IYuSheng/H_FOC-V3.0/boards/stm32g431/hardware/schematic.pdf

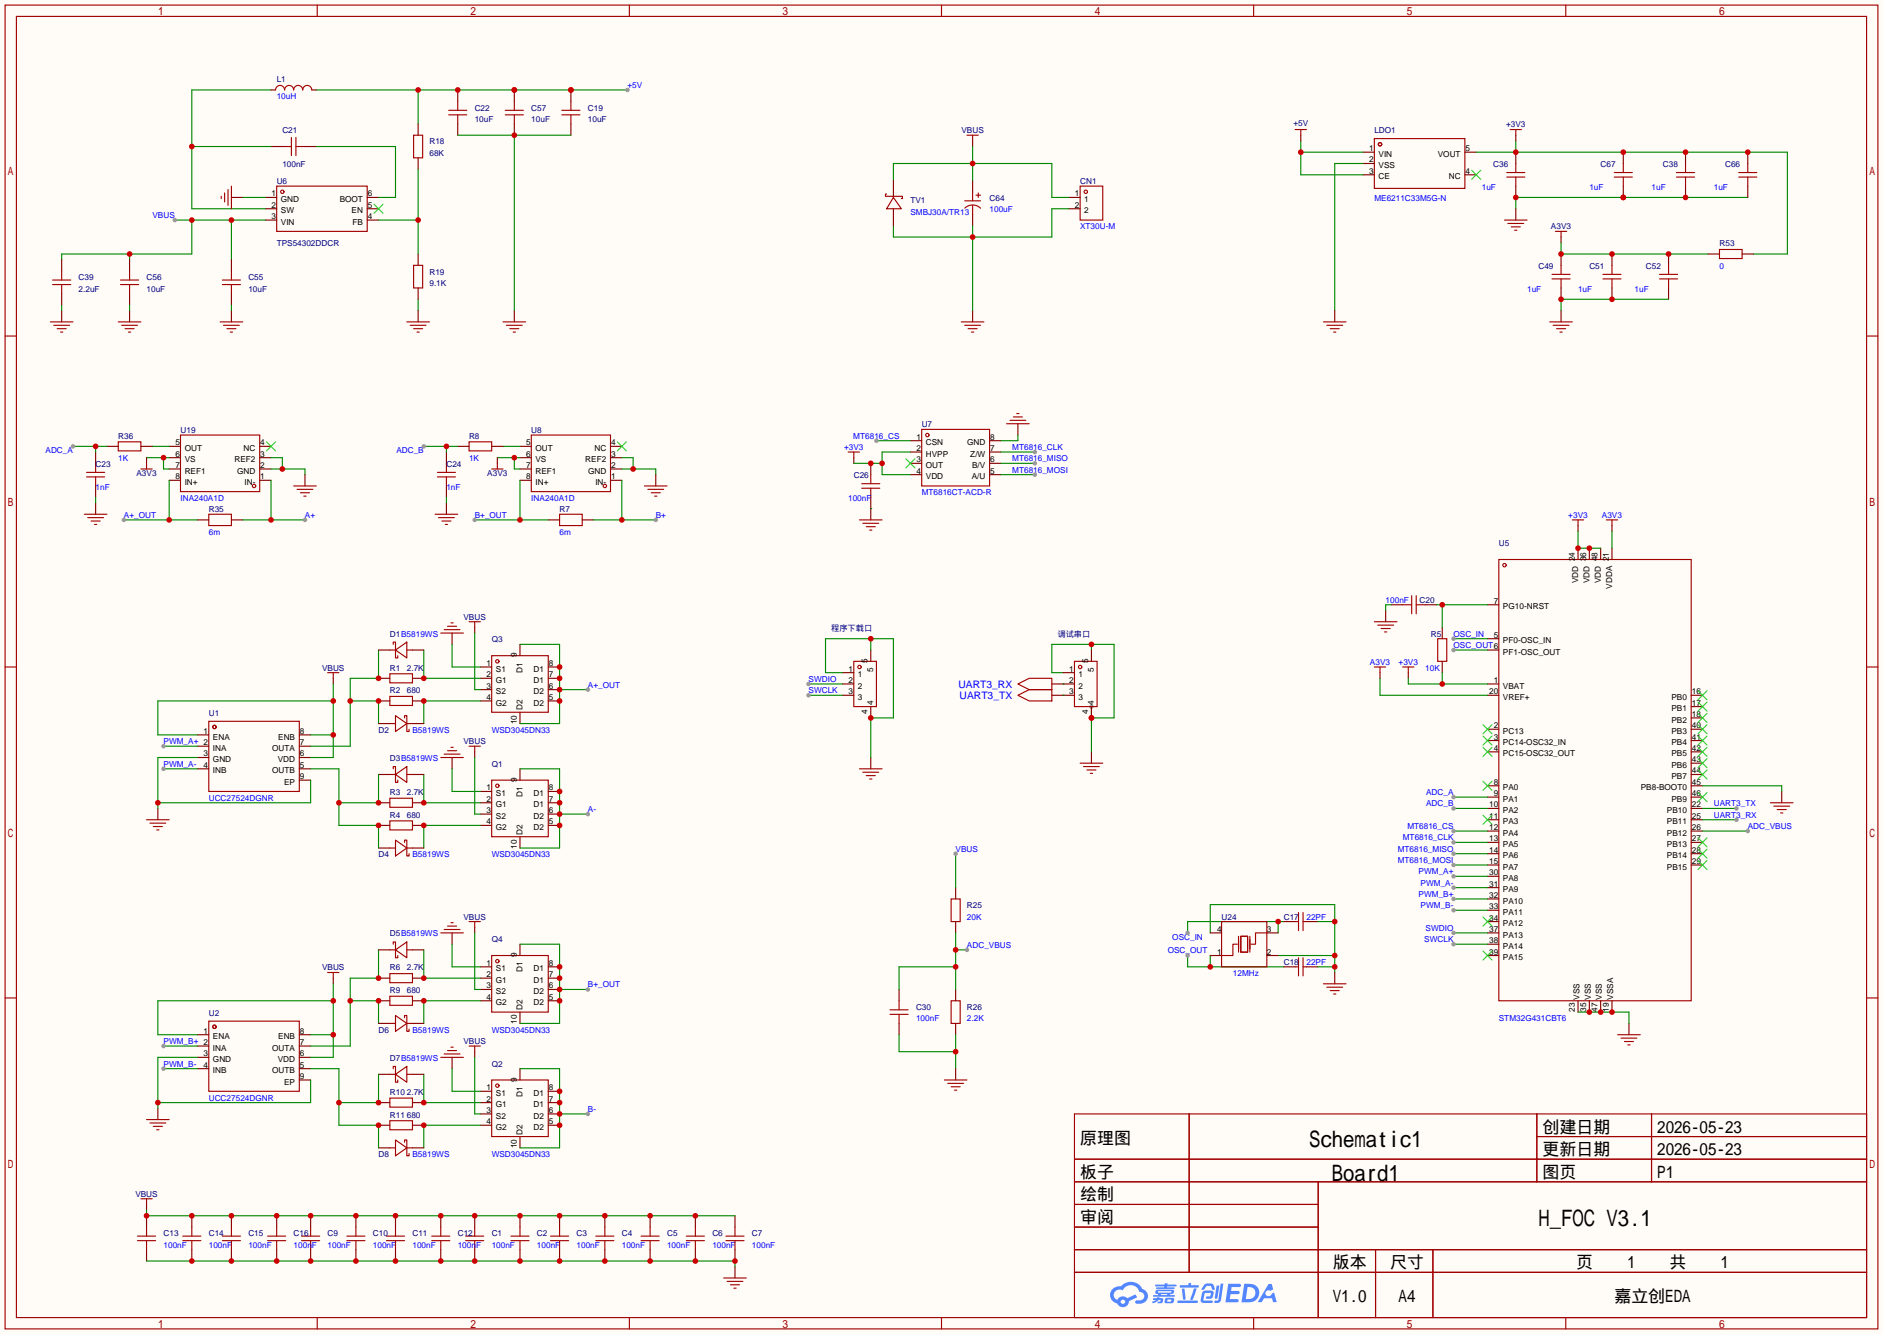
[picture p1: page 1]

原理图 | Schematic1 | 创建日期 | 2026-05-23

更新日期 | 2026-05-23

板子 | Board1 | 图页 | P1
绘制 | | H_FOC V3.1
审阅

V1.0 | A4 | 嘉立创EDA
