IYuSheng/H_FOC-V3.0/boards/stm32g431/hardware/PCB_bottom.pdf

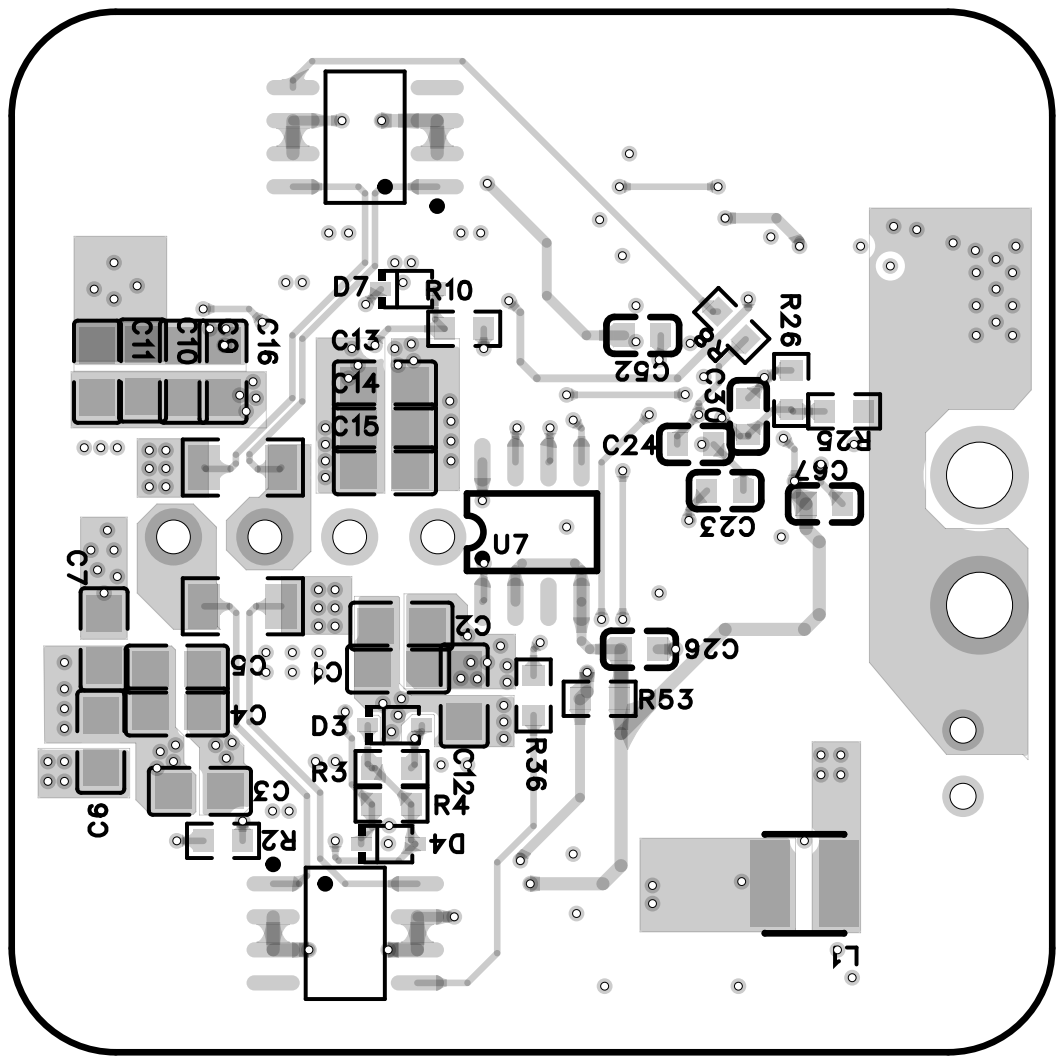
[picture p2: page 1]
