IYuSheng/H_FOC-V3.0/boards/stm32g431/hardware/PCB_top.pdf

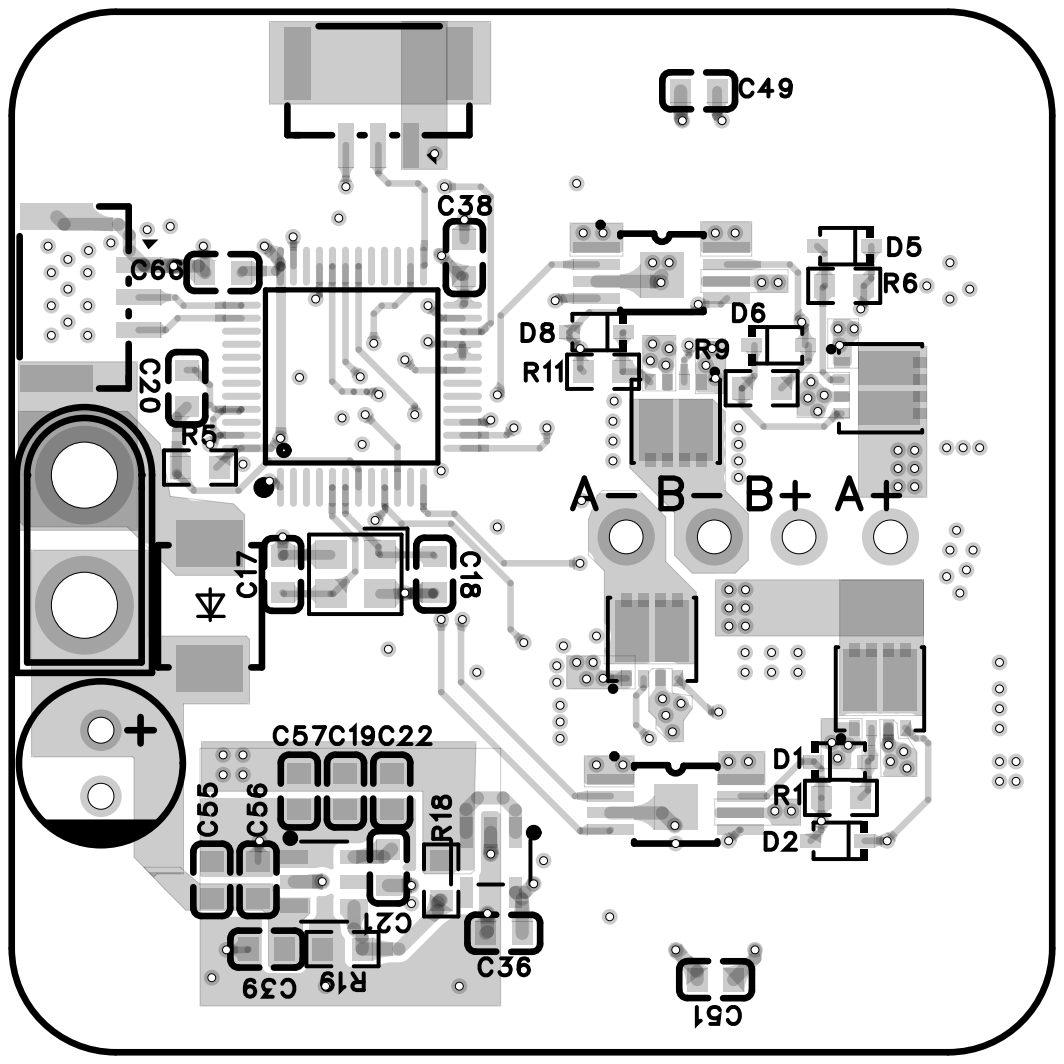
[picture p3: page 1]
