IYuSheng/H_FOC-V3.0/Code/MID/foc_conversion.c

#include "foc_conversion.h"

pi_t iq_pid;
pi_t id_pid;
pi_t speed_pid;
pi_t position_pid;
SVPWM_t svpwm;
SPWM_t spwm;
foc_control_t foc_ctrl;
AlphaBetaTypeDef alpha_beta;

/**
 * @brief 电角度归一化（映射到0~2π范围）
 * @param angle 输入电角度（rad，范围无限制）
 * @return 归一化后电角度（rad，0~2π）
 */
float angle_normalize(float angle)
{
    while (angle < 0.0f)   angle += _2PI;
    while (angle >= _2PI)  angle -= _2PI;
    return angle;
}

/**
 * @brief 电角度归一化（映射到-π~π范围）
 * @param angle 输入电角度（rad，范围无限制）
 * @return 归一化后电角度（rad，-π~π）
 */
float angle_normalize_pi(float angle)
{
    while (angle < -_PI)   angle += _2PI;
    while (angle >= _PI)  angle -= _2PI;
    return angle;
}

static inline float clampf(float x, float min_v, float max_v)
{
    if (x > max_v) return max_v;
    if (x < min_v) return min_v;
    return x;
}

/**
 * @brief SVPWM通用扇区判断函数
 * @param u_alpha α轴目标电压（V）
 * @param u_beta  β轴目标电压（V）
 * @return 扇区编号（1~6，对应一电角周期的六个扇区）
 */
uint8_t svpwm_sector_calc(AlphaBetaTypeDef *alpha_beta)
{
    uint8_t sector, pos1, pos2, pos3 = 0;

    float X = alpha_beta->beta;
    float Y = (_SQRT3  * alpha_beta->alpha - alpha_beta->beta);
    float Z = (-_SQRT3 * alpha_beta->alpha - alpha_beta->beta);

    pos1 = (X > 1e-6f) ? 1 : 0;
    pos2 = (Y > 1e-6f) ? 1 : 0;
    pos3 = (Z > 1e-6f) ? 1 : 0;

    sector = pos1 * 1 + pos2 * 2 + pos3 * 4;

    switch (sector)
    {
        case 3:  return 1;
        case 1:  return 2;
        case 5:  return 3;
        case 4:  return 4;
        case 6:  return 5;
        case 2:  return 6;
        default: return -1;
    }
}

/**
 * @brief SVPWM基本矢量作用时间计算
 * @param sector 当前扇区（1~6）
 * @param u_alpha α轴目标电压（V）
 * @param u_beta  β轴目标电压（V）
 * @param vdc 母线电压（V）
 * @param T1 第一个基本矢量作用时间（s）
 * @param T2 第二个基本矢量作用时间（s）
 * @param T0 零矢量总作用时间（s）
 */
void svpwm_calc_times(AlphaBetaTypeDef *alpha_beta, SVPWM_t *svpwm, float vdc)
{
    // 1) 计算幅值平方
    float alpha = alpha_beta->alpha;
    float beta  = alpha_beta->beta;
    float u_mag_sq = alpha * alpha + beta * beta;
    const float u_max = _1_SQRT3 * vdc;
    const float u_max_sq = u_max * u_max;

    // 2) 过调制处理
    if (u_mag_sq > u_max_sq && u_mag_sq > 1e-12f)
    {
        float u_mag = sqrtf(u_mag_sq);
        float scale = u_max / u_mag;
        alpha *= scale;
        beta  *= scale;
        alpha_beta->alpha = alpha;
        alpha_beta->beta  = beta;
    }

    // 3) 中间变量计算
    float factor = FACTOR / vdc;
    float half_factor = factor * 0.5f;
    float X = beta * factor;
    float Y = ( _SQRT3 * alpha + beta) * half_factor;
    float Z = (beta -_SQRT3 * alpha) * half_factor;

    // 4. 按扇区计算T1和T2（基于X/Y/Z）
    switch (svpwm->sector)
    {
        case 1:  // 扇区1：V4(100) + V6(110) → T1=-Z, T2=X 3
            svpwm->T1 = -Z;
            svpwm->T2 = X;
            break;
        case 2:  // 扇区2：V6(110) + V2(010) → T1=Z, T2=Y 1
            svpwm->T1 = Z;
            svpwm->T2 = Y;
            break;
        case 3:  // 扇区3：V2(010) + V3(011) → T1=X, T2=-Y 5
            svpwm->T1 = X;
            svpwm->T2 = -Y;
            break;
        case 4:  // 扇区4：V3(011) + V1(001) → T1=-X, T2=Z 4
            svpwm->T1 = -X;
            svpwm->T2 = Z;
            break;
        case 5:  // 扇区5：V1(001) + V5(101) → T1=-Y, T2=-Z 6
            svpwm->T1 = -Y;
            svpwm->T2 = -Z;
            break;
        case 6:  // 扇区6：V5(101) + V4(100) → T1=Y, T2=-X 2
            svpwm->T1 = Y;
            svpwm->T2 = -X;
            break;
        default:
            svpwm->T1 = 0.0f;
            svpwm->T2 = 0.0f;
            break;
    }

    // 6. 计算零矢量时间（确保T0≥0，避免负数）
    svpwm->T0 = PWM_PERIOD_S - svpwm->T1 - svpwm->T2;
    if (svpwm->T0 < 0.0f) svpwm->T0 = 0.0f;
}

/**
 * @brief SVPWM计算三相导通时间并转换为比较值
 * @param sector 当前扇区 (1-6)
 * @param T1 基本矢量1作用时间
 * @param T2 基本矢量2作用时间
 * @param T0 零矢量作用时间
 * @param pwm_a A相比较值指针
 * @param pwm_b B相比较值指针
 * @param pwm_c C相比较值指针
 */
void svpwm_duty_calc(SVPWM_t *svpwm)
{
    float Ta, Tb, Tc;                 // 三相桥臂导通时间（s）
    float T0_half = svpwm->T0 / 2.0f;

    // 按扇区计算三相导通时间
    switch (svpwm->sector)
    {
        case 1:  // 扇区1
            Ta = T0_half + svpwm->T1 + svpwm->T2;
            Tb = T0_half + svpwm->T2;
            Tc = T0_half;
            break;
        case 2:  // 扇区2
            Ta = T0_half + svpwm->T2;
            Tb = T0_half + svpwm->T1 + svpwm->T2;
            Tc = T0_half;
            break;
        case 3:  // 扇区3
            Ta = T0_half;
            Tb = T0_half + svpwm->T1 + svpwm->T2;
            Tc = T0_half + svpwm->T2;
            break;
        case 4:  // 扇区4
            Ta = T0_half;
            Tb = T0_half + svpwm->T2;
            Tc = T0_half + svpwm->T1 + svpwm->T2;
            break;
        case 5:  // 扇区5
            Ta = T0_half + svpwm->T2;
            Tb = T0_half;
            Tc = T0_half + svpwm->T1 + svpwm->T2;
            break;
        case 6:  // 扇区6
            Ta = T0_half + svpwm->T1 + svpwm->T2;
            Tb = T0_half;
            Tc = T0_half + svpwm->T2;
            break;
        default:  // 异常扇区
            Ta = T0_half;
            Tb = T0_half;
            Tc = T0_half;
            break;
    }
    // 导通时间→比较值
    const float k = PWM_FREQ_PERIOD;
    svpwm->pwm_a = Ta * k;
    svpwm->pwm_b = Tb * k;
    svpwm->pwm_c = Tc * k;
}

/**
 * @brief 生成单极性倍频SPWM波
 * @param spwm 四相spwm比较值指针
 * @param alpha_beta 输出的αβ轴值
 * @param vbus 母线电压
 */
void spwm_duty_calc(SPWM_t *spwm, AlphaBetaTypeDef *alpha_beta, float vbus)
{
    const float pwm_period = PWM_PERIOD;
    float UA = clampf(alpha_beta->alpha / vbus, -1.0f, 1.0f);
    float UB = clampf(alpha_beta->beta / vbus, -1.0f, 1.0f);
    // SPWM比较值计算
    spwm->duty_Ap = (uint32_t)((0.5f + 0.5f * UA) * pwm_period);
    spwm->duty_An = (uint32_t)((0.5f - 0.5f * UA) * pwm_period);
    spwm->duty_Bp = (uint32_t)((0.5f + 0.5f * UB) * pwm_period);
    spwm->duty_Bn = (uint32_t)((0.5f - 0.5f * UB) * pwm_period);
}

/**
 * @brief 将三相电流转换为αβ坐标系下的值
 * @param abc_i 三相电流指针
 * @param alpha_beta 输出的αβ轴值
 */
void clark_transform(void *abc_i, AlphaBetaTypeDef *alpha_beta)
{
    foc_data_i *current_abc = (foc_data_i *)abc_i;

    // 标准幅值不变性Clarke变换
    // α = (2/3)*ia + (-1/3)*ib + (-1/3)*ic
    // β = 0*ia + (1/√3)*ib + (-1/√3)*ic
    const float TWO_THIRD = 2.0f / 3.0f;
    const float ONE_THIRD = 1.0f / 3.0f;
    const float ONE_SQRT3 = _1_SQRT3;

    // 电流Clarke变换（a/b/c → α/β）
    alpha_beta->alpha_i = TWO_THIRD * current_abc->ia - ONE_THIRD * current_abc->ib - ONE_THIRD * current_abc->ic;
    alpha_beta->beta_i = ONE_SQRT3 * current_abc->ib - ONE_SQRT3 * current_abc->ic;
}

/**
 * @brief 将αβ转换为dq坐标系下的电流值
 * @param current_abc αβ电流值
 * @param current_αβ 输出的dq轴电流值
 */
void park_transform(AlphaBetaTypeDef *alpha_beta, foc_control_t *foc_ctrl, float sin_theta, float cos_theta)
{
    foc_ctrl->abc_dq.current_d = cos_theta * alpha_beta->alpha_i + sin_theta * alpha_beta->beta_i;
    foc_ctrl->abc_dq.current_q = -sin_theta * alpha_beta->alpha_i + cos_theta * alpha_beta->beta_i;
}

/**
 * @brief 反Park变换
 * @param d_ptr D轴输入指针
 * @param q_ptr Q轴输入指针
 * @param alpha_ptr Alpha轴输出指针
 * @param beta_ptr Beta轴输出指针
 * @param angle 电角度 (rad)
 */
void inv_park_transform_f32(foc_control_t *foc_ctrl, AlphaBetaTypeDef *alpha_beta, float sin_theta, float cos_theta)
{
    // 反Park变换：将旋转DQ坐标系电压转换为静止αβ坐标系电压
    alpha_beta->alpha = foc_ctrl->out_d * cos_theta - foc_ctrl->out_q * sin_theta;
    alpha_beta->beta = foc_ctrl->out_d * sin_theta + foc_ctrl->out_q * cos_theta;
}

/**
 * @brief D轴电流环PID计算
 * @param target_id 目标D轴电流
 * @param actual_id 实际D轴电流
 * @return D轴电压输出
 */
float foc_id_pid_calculate(float target_id, float actual_id)
{
    float error = target_id - actual_id;
    float p_term = id_pid.kp * error;

    // 积分项计算与限幅
    id_pid.integral += id_pid.ki * error;

    if (id_pid.integral > id_pid.integral_limit) {
        id_pid.integral = id_pid.integral_limit;
    } else if (id_pid.integral < -id_pid.integral_limit) {
        id_pid.integral = -id_pid.integral_limit;
    }

    float id_out = p_term + id_pid.integral;
    return id_out;
}

/**
 * @brief Q轴电流环PID计算
 * @param target_iq 目标Q轴电流
 * @param actual_iq 实际Q轴电流
 * @return Q轴电压输出
 */
float foc_iq_pid_calculate(float target_iq, float actual_iq)
{
    float error = target_iq - actual_iq;
    float p_term = iq_pid.kp * error;

    // 积分项计算与限幅
    iq_pid.integral += iq_pid.ki * error;

    if (iq_pid.integral > iq_pid.integral_limit) {
        iq_pid.integral = iq_pid.integral_limit;
    } else if (iq_pid.integral < -iq_pid.integral_limit) {
        iq_pid.integral = -iq_pid.integral_limit;
    }

    float iq_out = p_term + iq_pid.integral;
    return iq_out;
}

/**
 * @brief 速度环PID计算
 * @param target_speed 目标速度 (rad/s)
 * @param actual_speed 实际速度 (rad/s)
 * @return 输出值(Q轴电流)
 */
float foc_speed_pid_calculate(float target_speed, float actual_speed)
{
    float error = (target_speed - actual_speed);

    float p_term = speed_pid.kp * error;

    // 积分项计算与限幅
    speed_pid.integral += speed_pid.ki * error;

    if (speed_pid.integral > speed_pid.integral_limit) {
        speed_pid.integral = speed_pid.integral_limit;
    } else if (speed_pid.integral < -speed_pid.integral_limit) {
        speed_pid.integral = -speed_pid.integral_limit;
    }

    speed_pid.output = p_term + speed_pid.integral;
    if (speed_pid.output > SPEED_OUT_LIMIT)
    {
        speed_pid.output = SPEED_OUT_LIMIT;
    }
    else if (speed_pid.output < -SPEED_OUT_LIMIT)
    {
        speed_pid.output = -SPEED_OUT_LIMIT;
    }


    return speed_pid.output;
}

/**
 * @brief 位置环PI控制器计算
 * @param target_position 目标位置 (rad)
 * @param current_position 当前位置 (rad)
 * @return PI控制器输出（速度指令，rad/s）
 */
float foc_position_pid_calculate(float target_position, float current_position)
{
    float error, p_term, d_term;

    position_pid.target = target_position;
    position_pid.current = current_position;

    // 计算误差（目标 - 当前）
    error = target_position - current_position;
    // if(fabs(error) < 1.0f)
    // {
    //     position_pid.kd = POSITION_D_GAIN * fabs(error) / 1.0f;
    // }
    // else
    // {
    //     position_pid.kd = POSITION_D_GAIN;
    // }

    position_pid.w_ref = POSITION_KV * error; // 期望速度

    if(POSITION_W_MAX < position_pid.w_ref)
    {
        position_pid.w_ref = POSITION_W_MAX;
    }
    else if(position_pid.w_ref < -POSITION_W_MAX)
    {
        position_pid.w_ref = -POSITION_W_MAX;
    }

    // 计算微分项（速度误差阻尼）
    d_term = position_pid.kd * (position_pid.w_ref - encoder_data.mechanical_speed);

    position_pid.error = error;

    // 比例项
    p_term = position_pid.kp * error;

    // if(fabs(error) < 5.0f)
    {
        // 积分项累加
        position_pid.integral += position_pid.ki * error;

        // 积分限幅
        if (position_pid.integral > position_pid.integral_limit) {
            position_pid.integral = position_pid.integral_limit;
        } else if (position_pid.integral < -position_pid.integral_limit) {
            position_pid.integral = -position_pid.integral_limit;
        }
    }

    // 更新上次误差，用于下次计算微分项
    position_pid.last_error = error;

    // 输出 = 比例项 + 积分项
    position_pid.output = p_term + position_pid.integral + d_term;
    if(position_pid.output > POSITION_OUT_LIMIT)
    {
        position_pid.output = POSITION_OUT_LIMIT;
    }
    else if(position_pid.output < -POSITION_OUT_LIMIT)
    {
        position_pid.output = -POSITION_OUT_LIMIT;
    }

    return position_pid.output;
}
