IYuSheng/H_FOC-V3.0/src/modules/sensorless/mc_sensorless.h

/**
 * @file mc_sensorless.h
 * @brief 无位置传感器算法兼容汇总头。
 */

#ifndef MC_SENSORLESS_H_
#define MC_SENSORLESS_H_

#include "mc_flux_observer.h"
#include "mc_hfi_observer.h"
#include "mc_hfi_pll.h"

#endif /* MC_SENSORLESS_H_ */
