IYuSheng/H_FOC-V3.0/Code/APP/FOC_Init.h

#ifndef __FOC_INIT_H__
#define __FOC_INIT_H__

#include "stm32g4xx_hal.h"

#include "stm32g4xx_ll_adc.h"
#include "stm32g4xx_ll_cordic.h"
#include "stm32g4xx_ll_rcc.h"
#include "stm32g4xx_ll_bus.h"
#include "stm32g4xx_ll_crs.h"
#include "stm32g4xx_ll_system.h"
#include "stm32g4xx_ll_exti.h"
#include "stm32g4xx_ll_cortex.h"
#include "stm32g4xx_ll_utils.h"
#include "stm32g4xx_ll_pwr.h"
#include "stm32g4xx_ll_dma.h"
#include "stm32g4xx_ll_spi.h"
#include "stm32g4xx_ll_tim.h"
#include "stm32g4xx_ll_usart.h"
#include "stm32g4xx_ll_gpio.h"

#include "adc.h"
#include "cordic.h"
// #include "fdcan.h"
#include "spi.h"
#include "tim.h"
#include "usart.h"
#include "gpio.h"
#include "foc_encoder.h"
#include "foc_encoder_calibration.h"
#include "foc_frequency_sweep.h"
#include "foc_mechanical_param.h"
#include "foc_runtime.h"
#include "foc_sys.h"

void FOC_Init(void);
void foc_start(void);

#endif /*__ GPIO_H__ */
