IYuSheng/H_FOC-V3.0/Code/MID/foc_communication.c

#include "foc_communication.h"
#include <string.h>
uint8_t g_local_node_id = JOINT_ID;
joint_status_t remote_joint_status[JOINT_ID_MAX];
canfd_joint_cmd_t g_canfd_joint_cmd = {0};

void CAN_ReportStatus(void)
{
    joint_status_t status;

    status.position = FLOAT_TO_FIX(encoder_data.mechanical_angle);
    status.velocity = FLOAT_TO_FIX(encoder_data.mechanical_speed);
    status.current = FLOAT_TO_FIX(foc_ctrl.abc_dq.current_q_filt);
    status.temperature = FLOAT_TO_FIX(foc_voltage_data.temp);
    status.acceleration = FLOAT_TO_FIX(encoder_data.mechanical_accsd);

    FDCAN_SendJointStatus_Master(g_local_node_id, &status);
}

void CAN_ExecuteCommand(joint_control_t *cmd)
{
    memcpy(&joint_control, cmd, sizeof(joint_control));

    g_canfd_joint_cmd.target_current = FIX_TO_FLOAT(cmd->target_current);
    g_canfd_joint_cmd.target_angle = FIX_TO_FLOAT(cmd->target_angle);
    g_canfd_joint_cmd.target_velocity = FIX_TO_FLOAT(cmd->target_velocity);
    g_canfd_joint_cmd.target_acceleration = FIX_TO_FLOAT(cmd->target_acceleration);
    g_canfd_joint_cmd.target_jerk = FIX_TO_FLOAT(cmd->target_jerk);
    g_canfd_joint_cmd.stiffness = FIX_TO_FLOAT(cmd->stiffness);
    g_canfd_joint_cmd.damping = FIX_TO_FLOAT(cmd->damping);
    g_canfd_joint_cmd.control_mode = cmd->control_mode;
    g_canfd_joint_cmd.enabled = 1U;

    foc_ctrl.target_position = g_canfd_joint_cmd.target_angle;
    foc_ctrl.target_speed = g_canfd_joint_cmd.target_velocity;
}

void FDCAN_RxCallback(can_frame_t *frame)
{
    uint8_t type = CAN_ID_GET_TYPE(frame->id);
    uint8_t src = CAN_ID_GET_SRC(frame->id);

    switch (type) {
        case MSG_TYPE_CONTROL:
            if (src != JOINT_ID_MASTER) {
                return;
            }
            if (frame->len >= sizeof(joint_control_t)) {
                joint_control_t *cmd = (joint_control_t *)frame->data;
                CAN_ExecuteCommand(cmd);
            }
            break;

        case MSG_TYPE_STATUS:
            if (src >= JOINT_ID_MAX) {
                return;
            }
            if (frame->len >= sizeof(joint_status_t)) {
                /* status 消息处理暂未实现 */
            }
            break;

        default:
            break;
    }
}

void CAN_Process(void)
{
    FDCAN_ProcessRxQueue();
    FDCAN_Service();
}
