IYuSheng/H_FOC-V3.0/Code/Core/Inc/config.h

/* STM32CubeMX generated config header - minimal stub for GCC build */
#ifndef __CONFIG_MX_H
#define __CONFIG_MX_H

#ifdef __cplusplus
extern "C" {
#endif

/* Values already defined in stm32g4xx_hal_conf.h; no need to redefine here. */

#ifdef __cplusplus
}
#endif

#endif /* __CONFIG_MX_H */
