IYuSheng/H_FOC-V3.0/Code/MID/foc_encoder_calibration.c

#include "foc_encoder_calibration.h"

#include <stddef.h>
#include <string.h>

#include "Config.h"
#include "adc.h"
#include "cordic.h"
#include "foc_conversion.h"
#include "stm32g4xx_hal.h"
#include "tim.h"
#include "usart.h"

#if (FOC_ENCODER_CALIBRATION_SENSOR_PERIODS_PER_REV == 0U)
#error "FOC_ENCODER_CALIBRATION_SENSOR_PERIODS_PER_REV must be greater than 0"
#endif

#if ((FOC_ENCODER_CALIBRATION_SECTOR_COUNT %                                   \
      FOC_ENCODER_CALIBRATION_SENSOR_PERIODS_PER_REV) != 0U)
#error                                                                         \
    "FOC_ENCODER_CALIBRATION_SECTOR_COUNT must be divisible by SENSOR_PERIODS_PER_REV"
#endif

#if ((FOC_ENCODER_CALIBRATION_ENCODER_CPR %                                    \
      FOC_ENCODER_CALIBRATION_SENSOR_PERIODS_PER_REV) != 0U)
#error                                                                         \
    "FOC_ENCODER_CALIBRATION_ENCODER_CPR must be divisible by SENSOR_PERIODS_PER_REV"
#endif

#if ((MOTOR_POLE_PAIRS % FOC_ENCODER_CALIBRATION_SENSOR_PERIODS_PER_REV) != 0U)
#error                                                                         \
    "MOTOR_POLE_PAIRS must be divisible by SENSOR_PERIODS_PER_REV for unambiguous electrical angle"
#endif

/** d 轴校准开环电压，单位：V */
#define ENC_CAL_D_AXIS_VOLTAGE 2.0f
/** q 轴校准开环电压，校准时保持为 0，避免主动产生转矩 */
#define ENC_CAL_Q_AXIS_VOLTAGE 0.0f
/** 初始电角度锁定时间，单位：电流环 tick */
#define ENC_CAL_ALIGN_TICKS ((uint32_t)(0.50f / PWM_PERIOD_S))
/** Per-point settling time before capturing raw angle. */
#define ENC_CAL_SETTLE_TICKS ((uint32_t)(0.02f / PWM_PERIOD_S))
/** 每个校准点平均采样次数 */
#define ENC_CAL_SAMPLES_PER_POINT 8U
/** 方向检测和找零过程中的单步电角度增量，单位：rad */
#define ENC_CAL_ELEC_INC_RAD 0.000872664626f
/** 方向检测移动角度，单位：电角度 */
#define ENC_CAL_DIR_CHECK_RAD ENC_CAL_ELEC_STEP_RAD
/** 寻找零点前的最小预旋转整步数，避免刚启动阶段机械未稳定 */
#define ENC_CAL_ZERO_MIN_STEPS 20U
/** 正向采集结束后的超调整步数，用于消除反向采样回差 */
#define ENC_CAL_OVERSHOOT_STEPS 20U
/** Unique sectors in one repeated encoder magnetic period. */
#define ENC_CAL_ACTIVE_SECTOR_COUNT FOC_ENCODER_CALIBRATION_ACTIVE_SECTOR_COUNT
/** Unique table entries in one repeated encoder magnetic period. */
#define ENC_CAL_ACTIVE_TABLE_SIZE FOC_ENCODER_CALIBRATION_ACTIVE_TABLE_SIZE
/** Raw count span of one repeated encoder magnetic period. */
#define ENC_CAL_RAW_PERIOD_COUNTS FOC_ENCODER_CALIBRATION_ENCODER_PERIOD_COUNTS
/** Total electrical angle covered by one unique encoder magnetic period. */
#define ENC_CAL_TOTAL_ELEC_RAD                                                 \
    (_2PI * (float)MOTOR_POLE_PAIRS /                                          \
     (float)FOC_ENCODER_CALIBRATION_SENSOR_PERIODS_PER_REV)
/** 每个校准扇区对应的电角度步进，单位：rad */
#define ENC_CAL_ELEC_STEP_RAD                                                  \
    (ENC_CAL_TOTAL_ELEC_RAD / (float)ENC_CAL_ACTIVE_SECTOR_COUNT)
/** 每个校准扇区对应的机械角度步进，单位：rad */
#define ENC_CAL_MECH_STEP_RAD                                                  \
    (_2PI / (float)FOC_ENCODER_CALIBRATION_SECTOR_COUNT)
/** 相邻校准点最小允许间隔，理论值 period_counts/active_sectors，此处允许 -25%
 */
#define ENC_CAL_STEP_MIN_COUNTS                                                \
    ((ENC_CAL_RAW_PERIOD_COUNTS * 3U) / (ENC_CAL_ACTIVE_SECTOR_COUNT * 4U))
/** 相邻校准点最大允许间隔，理论值 period_counts/active_sectors，此处允许 +25%
 */
#define ENC_CAL_STEP_MAX_COUNTS                                                \
    ((ENC_CAL_RAW_PERIOD_COUNTS * 5U +                                         \
      (ENC_CAL_ACTIVE_SECTOR_COUNT * 4U - 1U)) /                               \
     (ENC_CAL_ACTIVE_SECTOR_COUNT * 4U))

/** STM32G431CB 最后一个 2 KB FLASH 页，链接脚本已从固件区排除。 */
#define ENC_CAL_FLASH_ADDRESS 0x0801F800UL
#define ENC_CAL_FLASH_PAGE    63U
#define ENC_CAL_FLASH_MAGIC   0x4543414CUL
#define ENC_CAL_FLASH_VERSION 1U

typedef struct
{
    uint32_t magic;
    uint16_t version;
    uint16_t sector_count;
    uint16_t sensor_periods_per_rev;
    int8_t direction;
    uint8_t reverse;
    int32_t linear_table[FOC_ENCODER_CALIBRATION_TABLE_SIZE];
    uint32_t crc32;
} enc_cal_flash_record_t;
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
