IYuSheng/H_FOC-V3.0/(notices)

Notices in the files:
Code/APP/foc_encoder.h:
Copyright (c) 2025 STMicroelectronics.
All rights reserved.
This software is licensed under terms that can be found in the LICENSE file
